JCCopyrights/ecube/doc/other/Foto 29-11-18 0 27 19.jpg

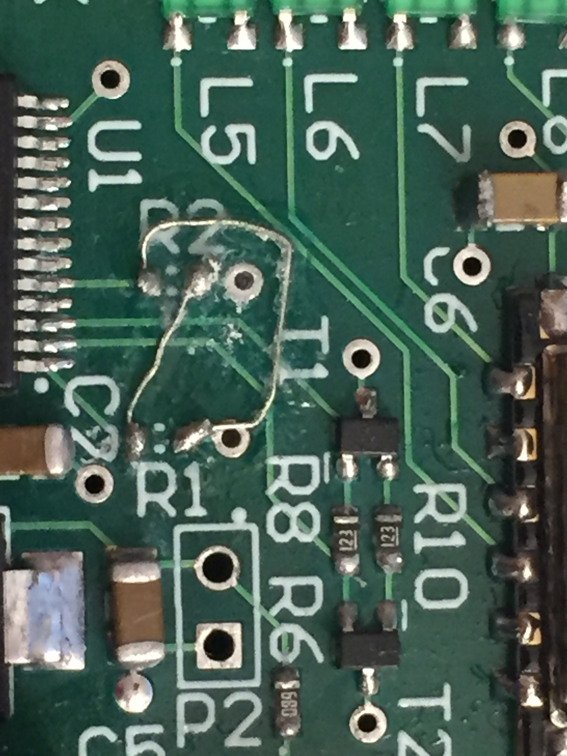
doc/other/Foto 29-11-18 0 27 19.jpg
