JCCopyrights/ecube/doc/other/Foto 19-11-18 21 11 56.jpg

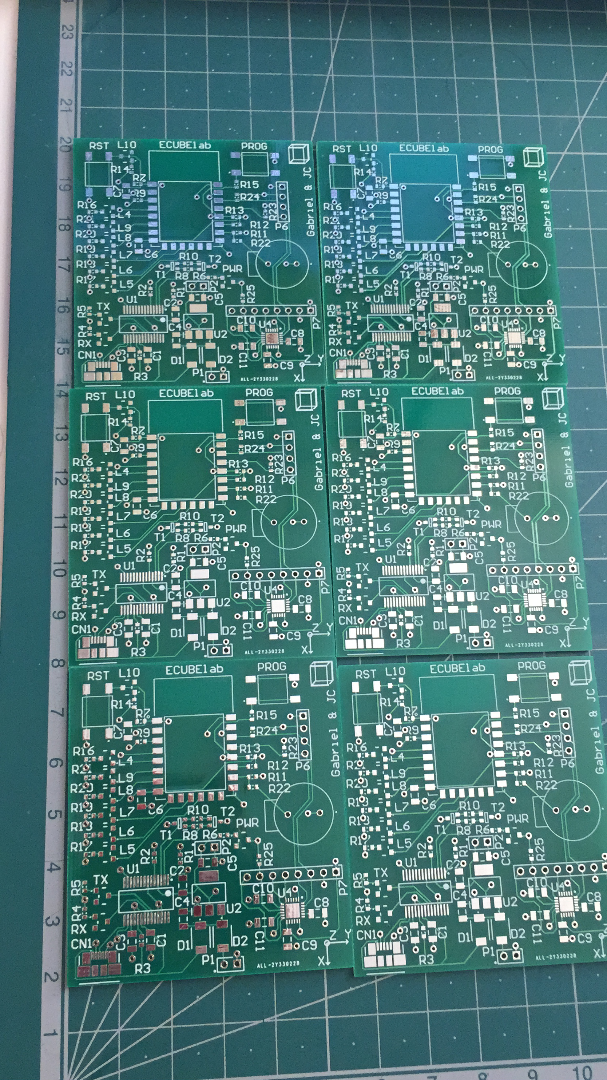
doc/other/Foto 19-11-18 21 11 56.jpg
