JCCopyrights/ecube/README.md

# ecube
Electronic Cube for domotic applications
Designed for WiFi-Mesh
Dependencies:
  #include <Arduino.h> 
  #include <Wire.h>
  #include <Adafruit_GFX.h>
  #include <Adafruit_SSD1306.h>
  #include <ESP8266WiFi.h>
  #include "I2Cdev.h"
  #include "MPU6050.h"
