JCCopyrights/ecube/doc/datasheet/ESP8266/esp8266_esp12e_horizontal-01.png

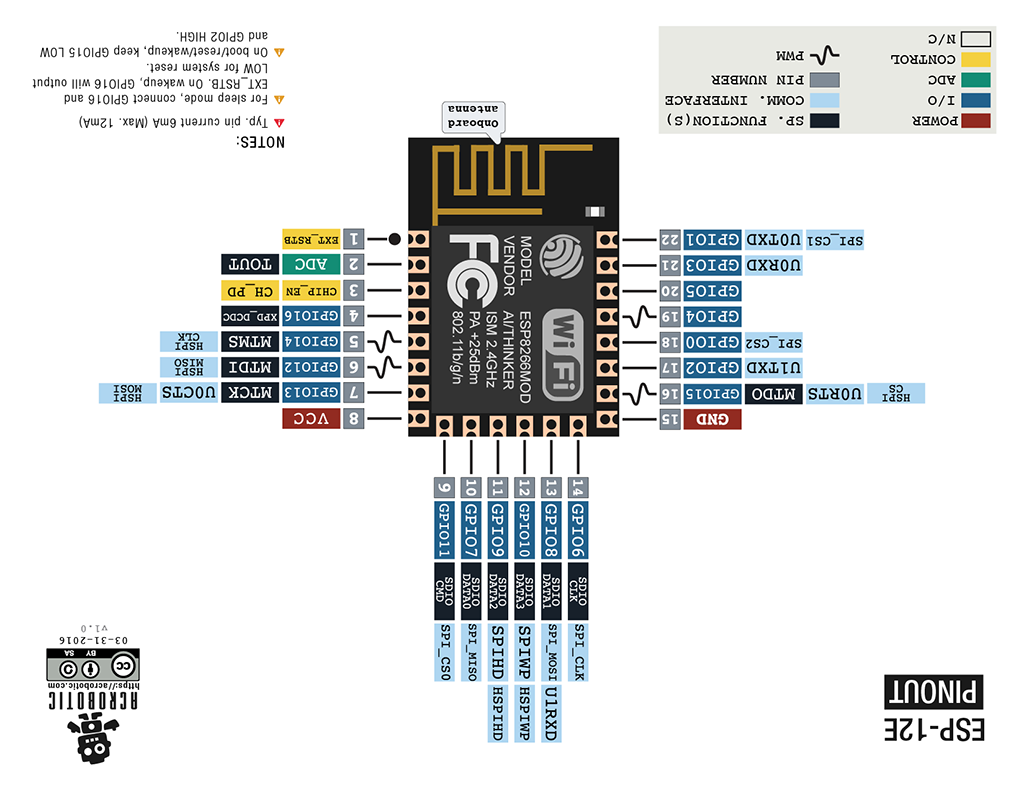
doc/datasheet/ESP8266/esp8266_esp12e_horizontal-01.png
