JCCopyrights/ecube/doc/other/Foto 15-11-18 0 23 40.jpg

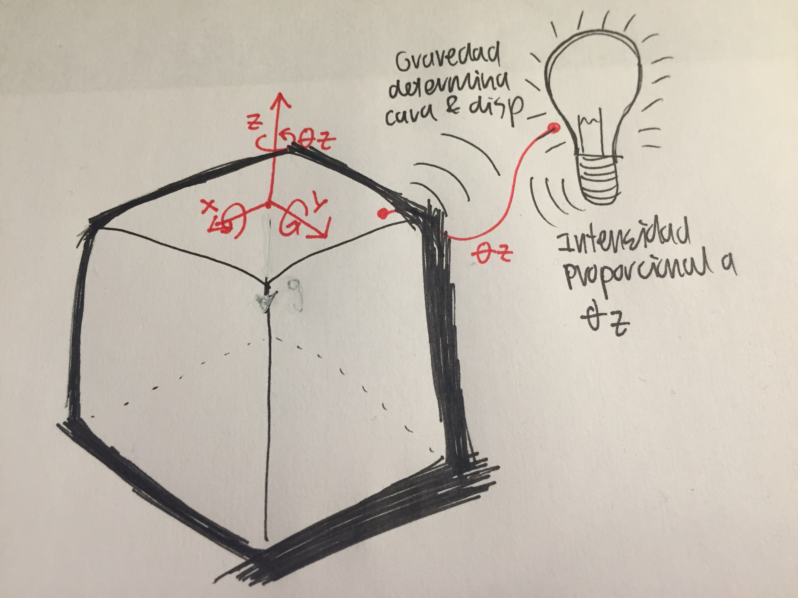
doc/other/Foto 15-11-18 0 23 40.jpg
