JCCopyrights/ecube/doc/other/Foto 20-12-18 1 25 45.jpg

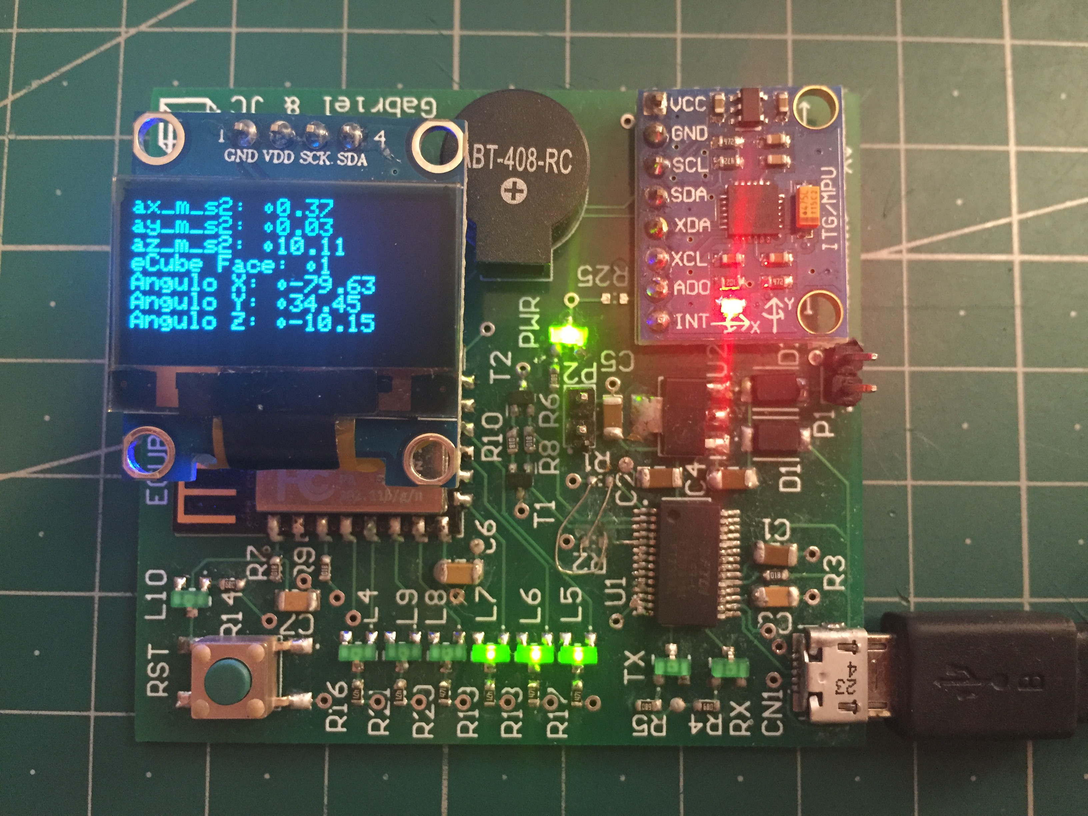
doc/other/Foto 20-12-18 1 25 45.jpg
