JCCopyrights/ecube/doc/other/Foto 21-11-18 14 55 43.jpg

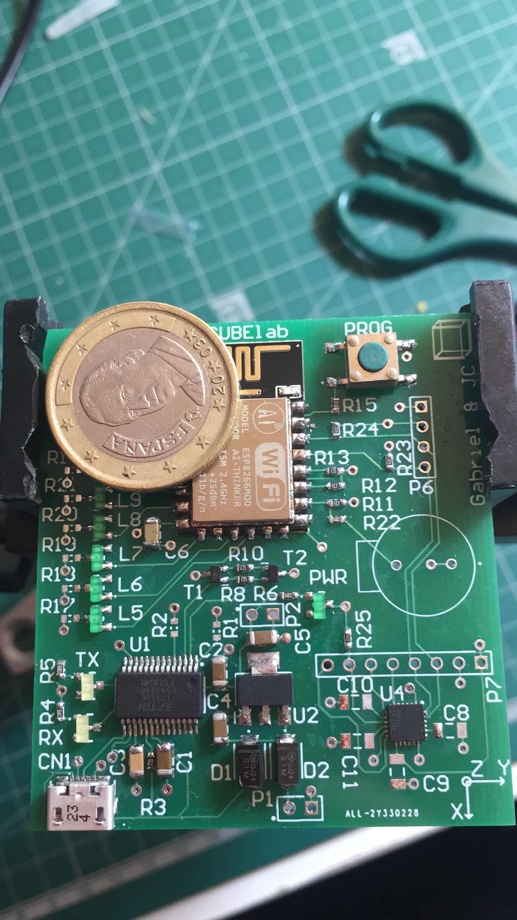
doc/other/Foto 21-11-18 14 55 43.jpg
