JCCopyrights/ecube/doc/other/Foto 29-11-18 0 26 48.jpg

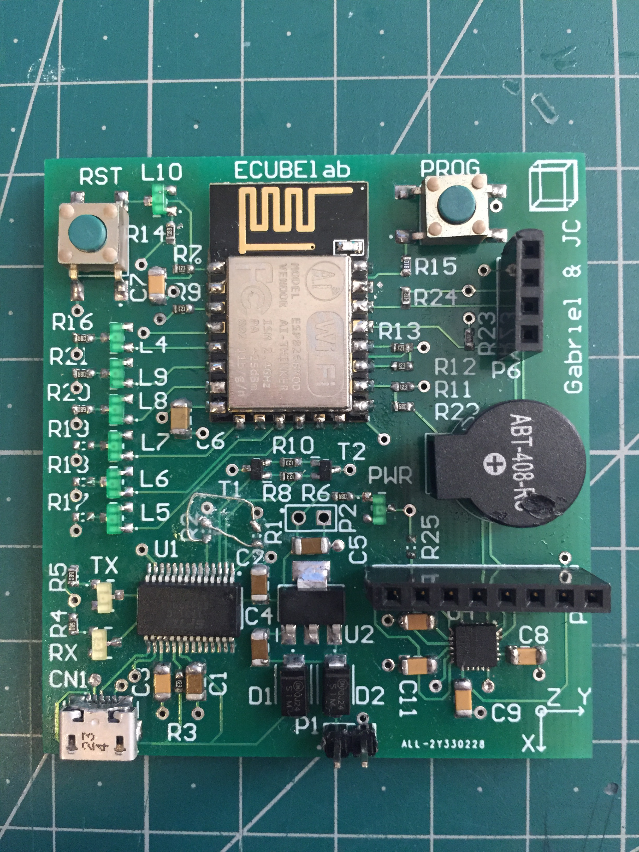
doc/other/Foto 29-11-18 0 26 48.jpg
