JCCopyrights/ecube/doc/other/Foto 29-11-18 0 27 49.jpg

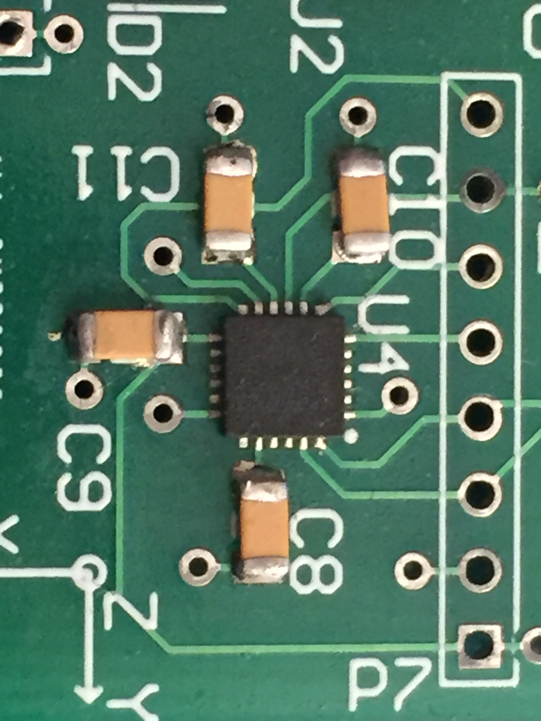
doc/other/Foto 29-11-18 0 27 49.jpg
