JCCopyrights/ecube/doc/other/web.png

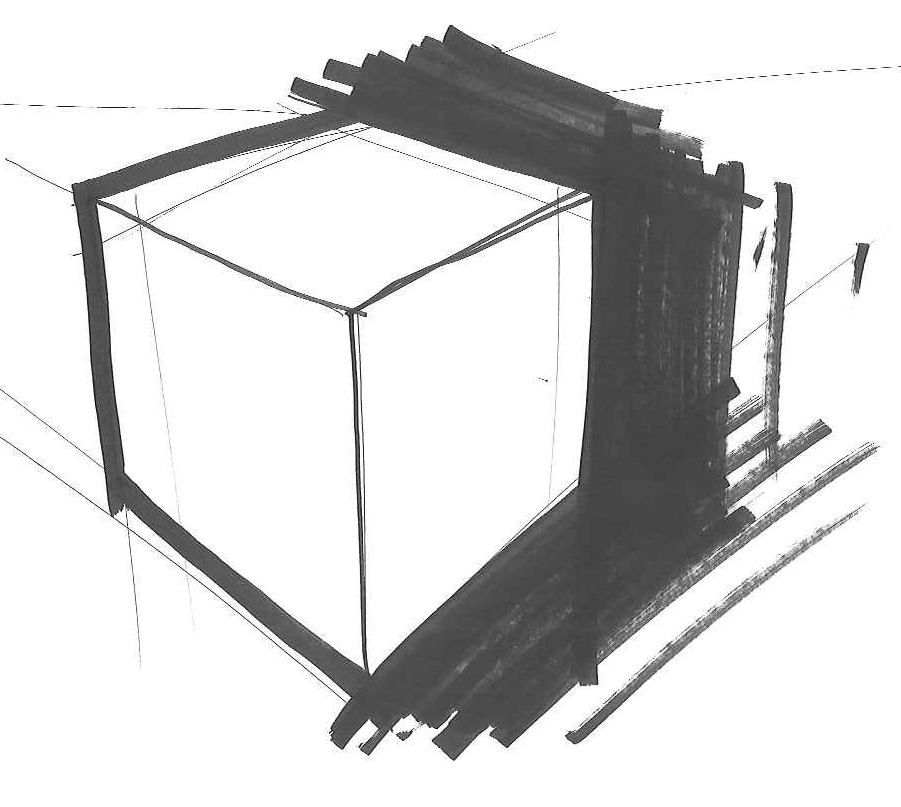
doc/other/web.png
