JCCopyrights/ecube/hw/ComponentSearch/LIB_MPU-6050/MPU-6050/3D/MPU-6050.stp

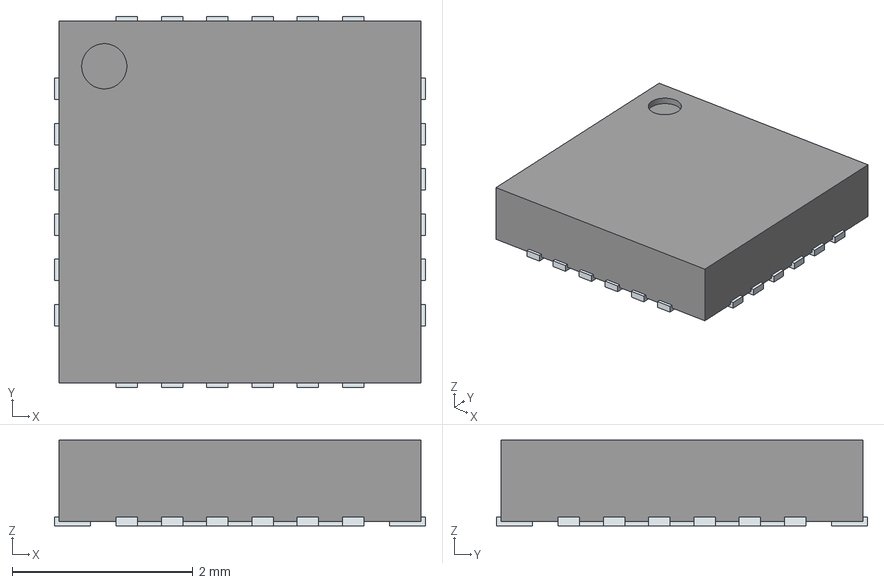
[picture p37: CAD file, 2018-11-12]
hw/ComponentSearch/LIB_MPU-6050/MPU-6050/3D/MPU-6050.stp
4.10 x 4.10 x 0.95 mm
ThermalPin
PinsArrayLR
PinsArrayTB
