JCCopyrights/ecube/hw/ComponentSearch/LIB_SBC846BWT1G/SBC846BWT1G/3D/SBC846BWT1G.stp

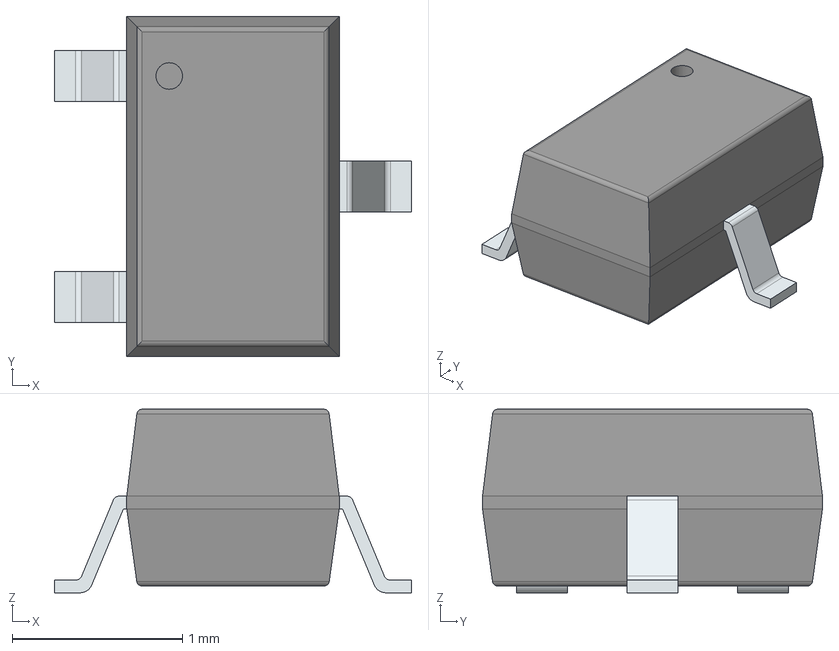
[picture p38: CAD file, 2018-11-12]
hw/ComponentSearch/LIB_SBC846BWT1G/SBC846BWT1G/3D/SBC846BWT1G.stp
2.10 x 2.00 x 1.08 mm
PinsArrayL
FilletPinR
