JCCopyrights/ecube/(list of files, cad)

Other CAD files:
hw/ComponentSearch/LIB_MPU-6050/MPU-6050/3D/MPU-6050.stl
hw/ComponentSearch/LIB_SBC846BWT1G/SBC846BWT1G/3D/SBC846BWT1G.stl
