JCCopyrights/ecube/doc/schematic.pdf

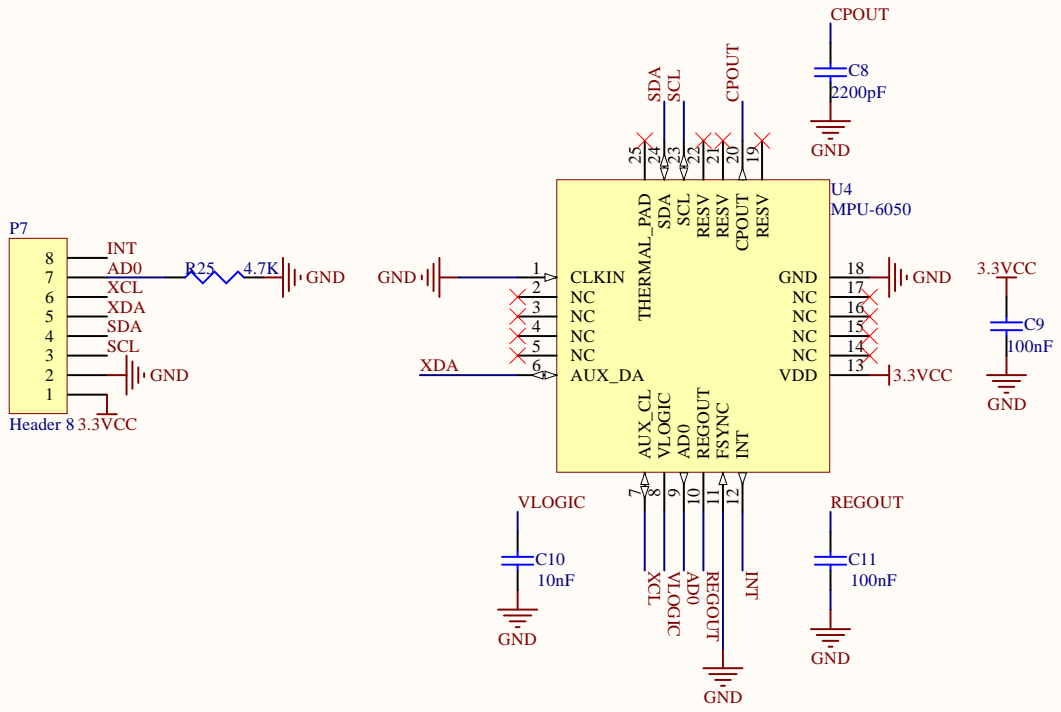
[picture p39: page 1]

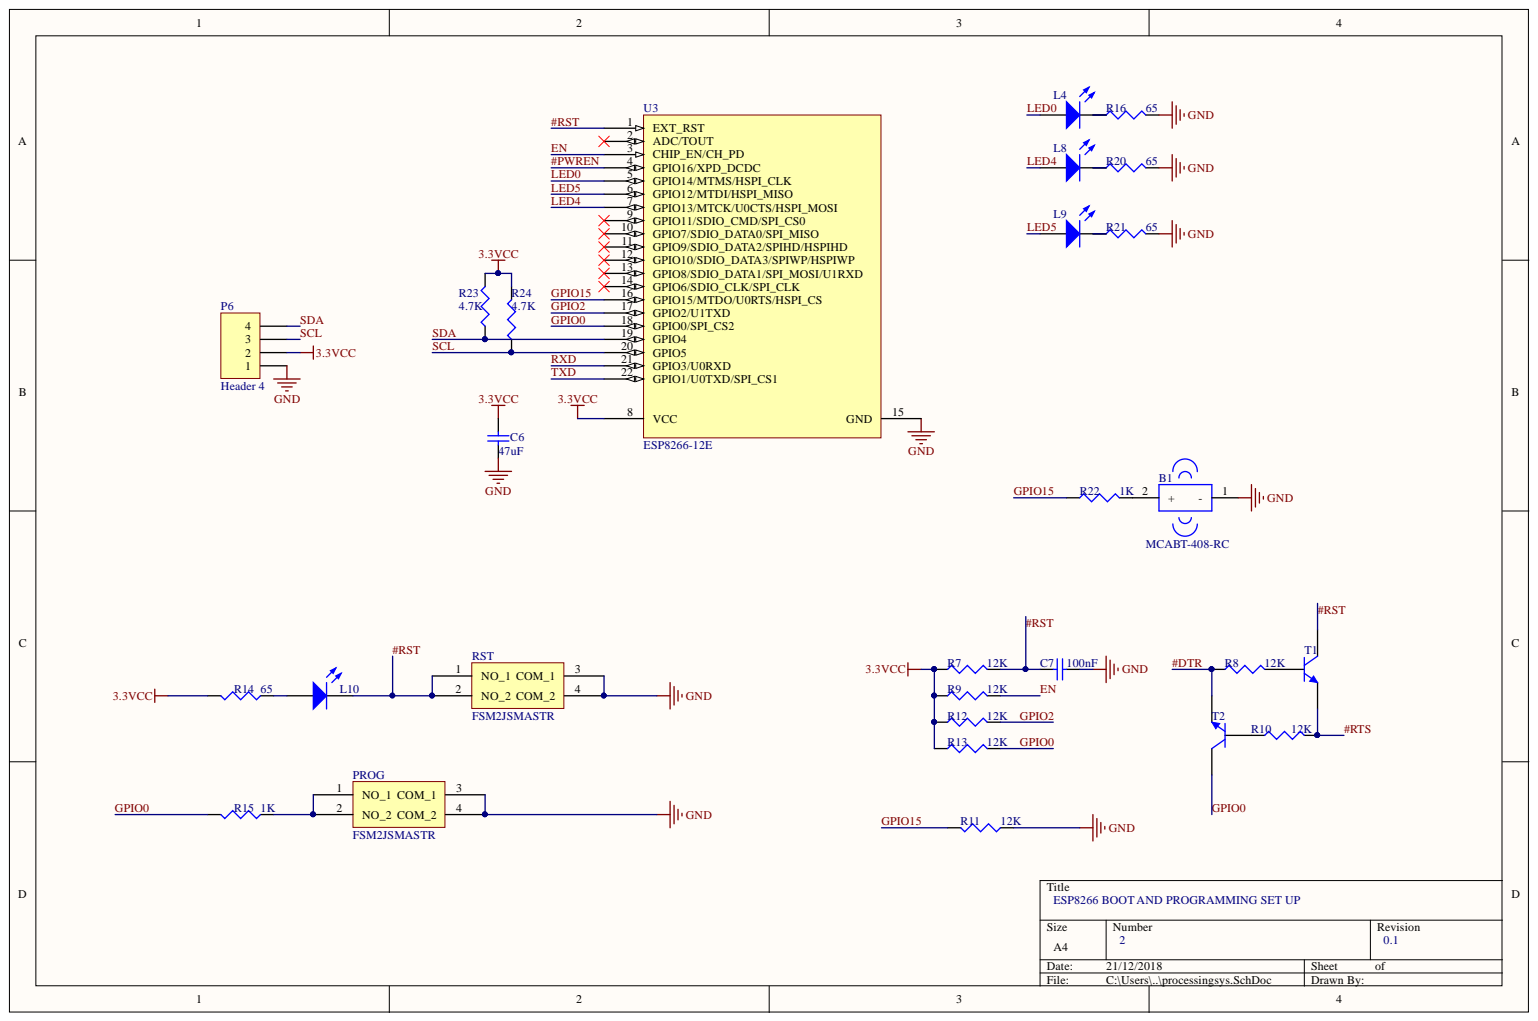
[picture p40: page 2]

Title
ESP8266 BOOT AND PROGRAMMING SET UP

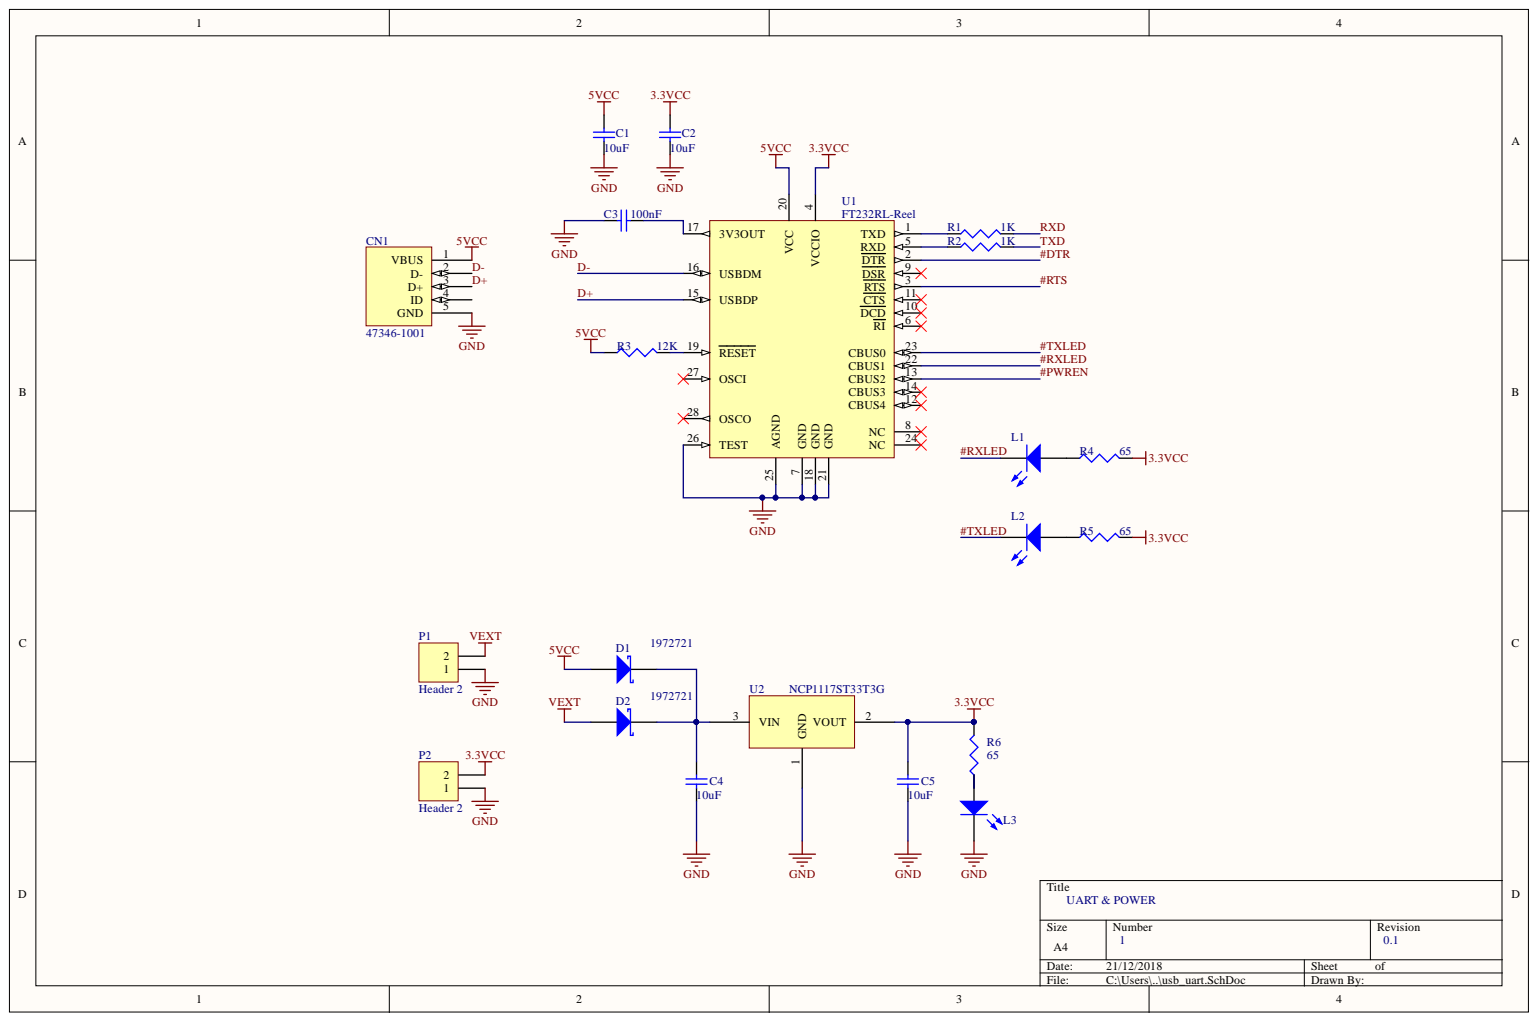
[picture p41: page 3]

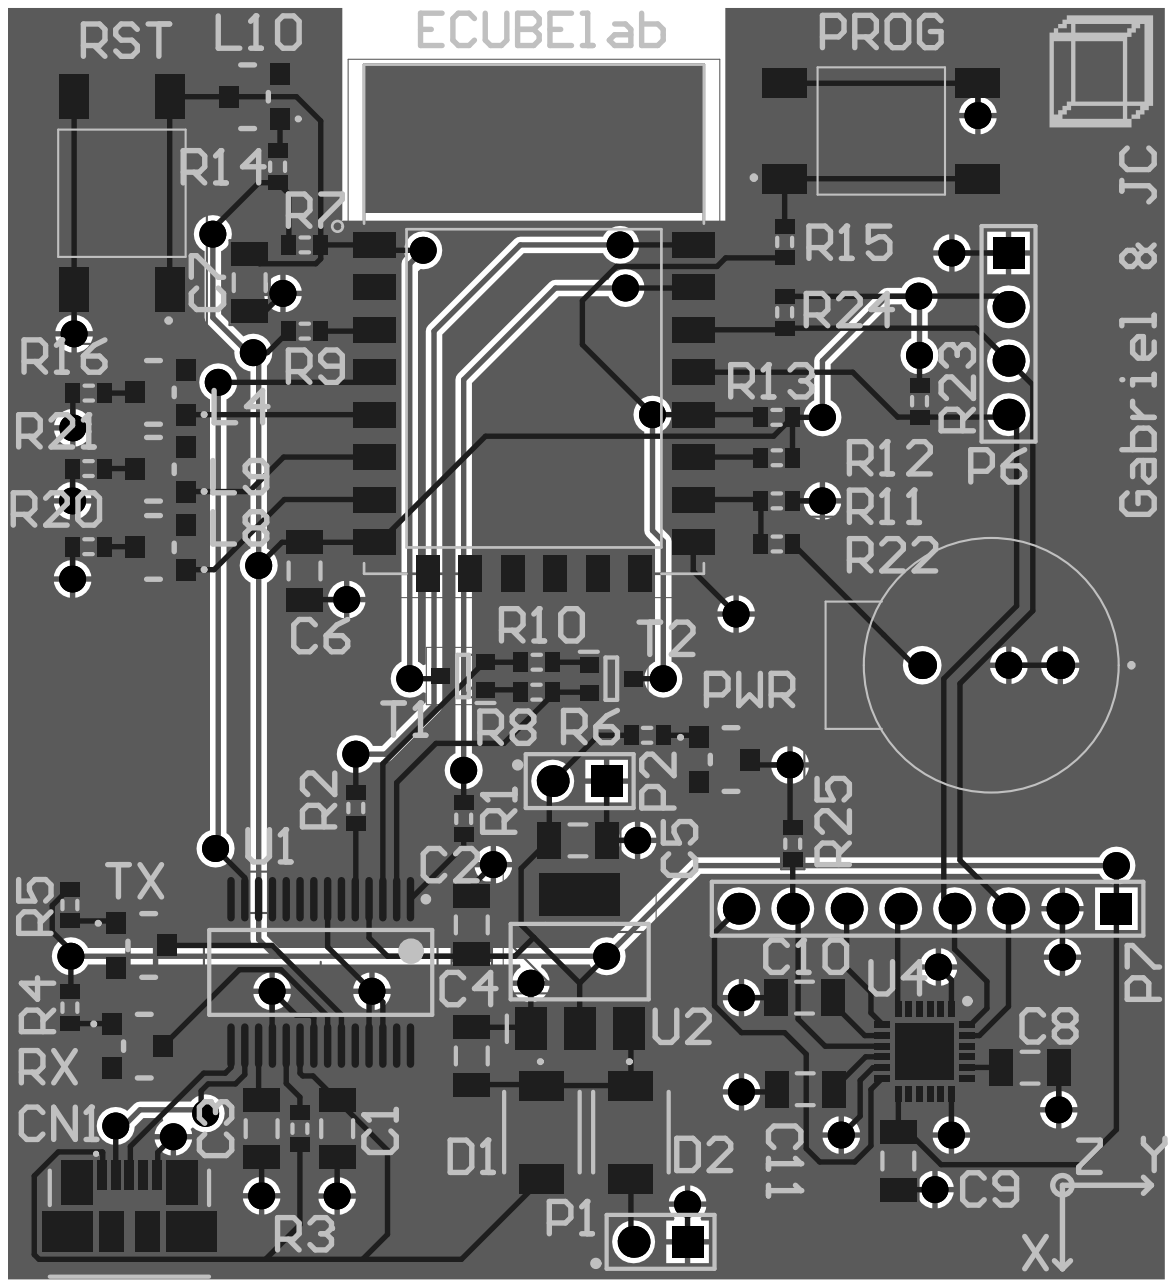
[picture p42: page 4]
