JCCopyrights/ecube/doc/Report/ecube.pdf

Title
ESP8266 BOOT AND PROGRAMMING SET UP
