JCCopyrights/ecube/(list of files, drawings)

Other design files:
hw/ComponentSearch/ESP8266-12E_ESP-12E/Imported ESP8266-12E_ESP-12E.lia/ESP8266-12E_ESP-12E.PcbLib
hw/ComponentSearch/ESP8266-12E_ESP-12E/Imported ESP8266-12E_ESP-12E.lia/ESP8266-12E_ESP-12E.SchLib
hw/ComponentSearch/LIB_47346-1001/47346-1001/Altium/Imported PADS Libraries.PrjPcb/47346-0001.PcbLib
hw/ComponentSearch/LIB_47346-1001/47346-1001/Altium/Imported PADS Libraries.PrjPcb/47346-1001.SchLib
hw/ComponentSearch/LIB_47346-1001/47346-1001/Altium/Imported PADS Libraries.PrjPcb/PADS Libraries.PrjPcb
hw/ComponentSearch/LIB_FSM2JSMASTR/FSM2JSMASTR/Altium/Imported PADS Libraries.PrjPcb/FSM2JSMASTR.PcbLib
hw/ComponentSearch/LIB_FSM2JSMASTR/FSM2JSMASTR/Altium/Imported PADS Libraries.PrjPcb/FSM2JSMASTR.SchLib
hw/ComponentSearch/LIB_FSM2JSMASTR/FSM2JSMASTR/Altium/Imported PADS Libraries.PrjPcb/PADS Libraries.PrjPcb
hw/ComponentSearch/LIB_KM-23ID-F/KM-23ID-F/Altium/Imported PADS Libraries.PrjPcb/KM-23ID-F.SchLib
hw/ComponentSearch/LIB_KM-23ID-F/KM-23ID-F/Altium/Imported PADS Libraries.PrjPcb/PADS Libraries.PrjPcb
hw/ComponentSearch/LIB_KM-23ID-F/KM-23ID-F/Altium/Imported PADS Libraries.PrjPcb/SOT-23.PcbLib
hw/ComponentSearch/LIB_MCABT-408-RC/MCABT-408-RC/Altium/Imported PADS Libraries.PrjPcb/MCABT408RC.PcbLib
hw/ComponentSearch/LIB_MCABT-408-RC/MCABT-408-RC/Altium/Imported PADS Libraries.PrjPcb/MCABT-408-RC.SchLib
hw/ComponentSearch/LIB_MCABT-408-RC/MCABT-408-RC/Altium/Imported PADS Libraries.PrjPcb/PADS Libraries.PrjPcb
hw/ComponentSearch/LIB_MPU-6050/MPU-6050/Altium/Imported PADS Libraries.PrjPcb/MPU-6050.SchLib
hw/ComponentSearch/LIB_MPU-6050/MPU-6050/Altium/Imported PADS Libraries.PrjPcb/PADS Libraries.PrjPcb
hw/ComponentSearch/LIB_MPU-6050/MPU-6050/Altium/Imported PADS Libraries.PrjPcb/QFN50P400X400X95-25N.PcbLib
hw/ComponentSearch/LIB_NCP1117ST33T3G/NCP1117ST33T3G/Altium/Imported PADS Libraries.PrjPcb/NCP1117ST33T3G.SchLib
hw/ComponentSearch/LIB_NCP1117ST33T3G/NCP1117ST33T3G/Altium/Imported PADS Libraries.PrjPcb/PADS Libraries.PrjPcb
hw/ComponentSearch/LIB_NCP1117ST33T3G/NCP1117ST33T3G/Altium/Imported PADS Libraries.PrjPcb/SOT230P700X180-4N.PcbLib
hw/ComponentSearch/LIB_PMEG3020DEP,115/PMEG3020DEP,115/Altium/Imported PADS Libraries.PrjPcb/PADS Libraries.PrjPcb
hw/ComponentSearch/LIB_PMEG3020DEP,115/PMEG3020DEP,115/Altium/Imported PADS Libraries.PrjPcb/PMEG3020DEP_115.SchLib
hw/ComponentSearch/LIB_PMEG3020DEP,115/PMEG3020DEP,115/Altium/Imported PADS Libraries.PrjPcb/SOD128.PcbLib
hw/ComponentSearch/LIB_SBC846BWT1G/SBC846BWT1G/Altium/Imported PADS Libraries.PrjPcb/PADS Libraries.PrjPcb
hw/ComponentSearch/LIB_SBC846BWT1G/SBC846BWT1G/Altium/Imported PADS Libraries.PrjPcb/SBC846BWT1G.SchLib
hw/ComponentSearch/LIB_SBC846BWT1G/SBC846BWT1G/Altium/Imported PADS Libraries.PrjPcb/SOT65P210X108-3N.PcbLib
hw/ecube.PrjPCB
hw/ecubelib.PcbLib
hw/ecubelib.SchLib
hw/mpu6050.SchDoc
hw/PCB1.PcbDoc
hw/processingsys.SchDoc
hw/usb_uart.SchDoc
