JCCopyrights/ecube/(commit log)

2018-11-12 Manufacturers added
    [PCB1.PcbDoc, ecube.PrjPCB, ecubelib.SchLib, mpu6050.SchDoc, processingsys.SchDoc, usb_uart.SchDoc]
2018-11-13 Keep Out Layer Updated
    [PCB1.PcbDoc, ecube.PrjPCB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]
2018-11-13 Removed Ground Plane under the ESP
    [47346-0001.PcbLib, 47346-1001.SchLib, EDI2CAP.CFG, ESP8266-12E_ESP-12E.PcbLib, ESP8266-12E_ESP-12E.SchLib, FSM2JSMASTR.PcbLib, FSM2JSMASTR.SchLib, KM-23ID-F.SchLib]
2018-11-15 Updated BOM and fixed C,R values
    [Componentes.xlsx, mpu6050.SchDoc, processingsys.SchDoc, usb_uart.SchDoc]
2018-11-29 Fixed RX-TX in UART, deleted LEDs connected to SPI
    [PCB1.PcbDoc, processingsys.SchDoc, usb_uart.SchDoc]
2018-12-22 Added new documentation, HTML unitary test server created
    [Componentes.xlsx]
